Gheim2/Lidarino/src/lidarino_description/urdf/meshes/base_link_s2.stl

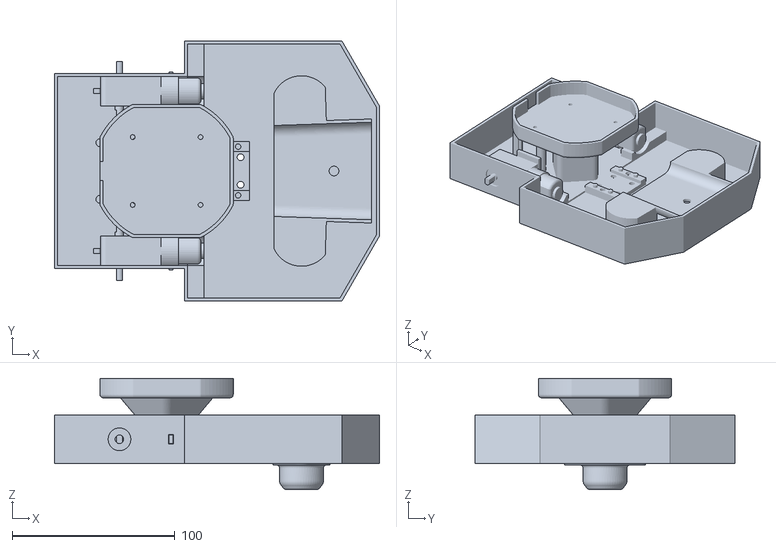
[picture p1: CAD file, 2026-06-29]
src/lidarino_description/urdf/meshes/base_link_s2.stl
200.0 x 160.0 x 68.5
