Gheim2/Lidarino/src/lidarino_description/urdf/meshes/wheel_L.stl

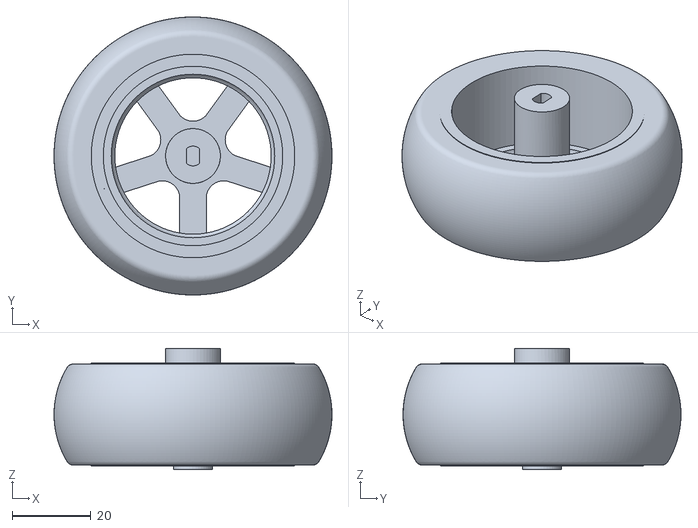
[picture p2: CAD file, 2026-05-26]
src/lidarino_description/urdf/meshes/wheel_L.stl
70.5 x 70.5 x 30.8
