Gheim2/Lidarino/(list of files, cad)

Other CAD files:
src/lidarino_description/urdf/meshes/bodyLid.stl
src/lidarino_description/urdf/meshes/astracamera.stl
src/lidarino_description/urdf/meshes/lidar.stl
src/lidarino_description/urdf/meshes/RPLIDARS2.stl
src/lidarino_description/urdf/meshes/base_link.stl
src/lidarino_description/urdf/meshes/wheel_R.stl
