Gheim2/Lidarino/src/lidarino_description/urdf/lidarino_core_s2.xacro

<?xml version='1.0' encoding='utf-8'?>
<robot xmlns:xacro="http://www.ros.org/wiki/xacro" name="Lidarino">
    
    <link name="base_link">
        <inertial>
            <origin xyz="-0.0062724127968771535 1.3799035175597654e-08 0.013070827636125267" rpy="0.0 0.0 0.0" />
            <mass value="0.4239314641509377" />
            <inertia ixx="0.0010482842137546186" iyy="0.0024338106744802982" izz="0.003184067568059869" ixy="-9.417101996162051e-05" iyz="-2.234993490616969e-06" ixz="0.0001129151524043299" />
        </inertial>
        <visual name="base_link_visual">
            <origin xyz="0.0 0.0 0.0" rpy="0.0 0.0 0.0" />
            <geometry>
                <mesh filename="${mesh_url}base_link_s2.stl" scale="0.001 0.001 0.001" />
            </geometry>
            <material name="steel_blue" />
        </visual>
        <collision name="base_link_collision">
            <origin xyz="0.0 0.0 0.021" rpy="0.0 0.0 0.0" />
            <geometry>
                <box size="0.25 0.16 0.042" /> 
            </geometry>
        </collision>
    </link>

    <link name="body_lid">
        <inertial>
            <origin xyz="-0.012951394456098867 -3.147938388524642e-07 0.06881041966340294" rpy="0.0 0.0 0.0" />
            <mass value="0.05261379951215123" />
            <inertia ixx="0.0001489352862801382" iyy="0.000229958819591738" izz="0.00037746798651689653" ixy="3.80132469862603e-10" iyz="3.2124298873716476e-11" ixz="-6.825968075725163e-07" />
        </inertial>
        <visual name="body_lid_visual">
            <origin xyz="0.0 0.0 -0.07" rpy="0.0 0.0 0.0" />
            <geometry>
                <mesh filename="${mesh_url}bodyLid.stl" scale="0.001 0.001 0.001" />
            </geometry>
            <material name="steel_blue" />
        </visual>
        <collision name="body_lid_collision">
            <origin xyz="-0.024 0.0 -0.005" rpy="0.0 0.0 0.0" />
            <geometry>
                <box size="0.206 0.164 0.014" /> 
            </geometry>
        </collision>
    </link>

    <link name="caster">
        <inertial>
            <origin xyz="0.0 0.0 0.0" rpy="0.0 0.0 0.0" />
            <mass value="0.01" />
            <inertia ixx="1e-6" iyy="1e-6" izz="1e-6" ixy="0" iyz="0" ixz="0" />
        </inertial>
        <visual name="caster_visual">
            <origin xyz="0.0 0.0 0.0" rpy="0.0 0.0 0.0" />
            <geometry>
                <sphere radius="0.008" />
            </geometry>
            <material name="silver" />
        </visual>
        <collision name="caster_collision">
            <origin xyz="0.0 0.0 0.0" rpy="0.0 0.0 0.0" />
            <geometry>
                <sphere radius="0.008" />
            </geometry>
        </collision>
    </link>
    
    <link name="wheel_R">
        <inertial>
            <origin xyz="3.8589283501977436e-08 3.3503422258718277e-13 -0.017044397508191807" rpy="0.0 -0.0 0.0" />
            <mass value="0.0493089812577897" />
            <inertia ixx="2.1725366580018456e-05" iyy="2.172573834724608e-05" izz="3.791921679166611e-05" ixy="5.925842498991085e-17" iyz="1.1233689759665433e-16" ixz="1.2860682814920879e-11" />
        </inertial>
        <visual name="wheel_R_visual">
            <origin xyz="1.1368683772161603e-15 1.3322676295501878e-17 0.0" rpy="-4.72621546065603e-16 -1.1102230246251568e-16 -2.7755575615628926e-17" />
            <geometry>
                <mesh filename="${mesh_url}wheel_R.stl" scale="0.001 0.001 0.001" />
            </geometry>
            <material name="black" />
        </visual>
        <collision name="wheel_R_collision">
            <origin xyz="0 0 -0.017" rpy="0 0 0" />
            <geometry>
                <sphere radius="0.035" />
            </geometry>
        </collision>
    </link>

    <link name="wheel_L">
        <inertial>
            <origin xyz="3.8589283501977436e-08 3.3503422258718277e-13 -0.017044397508191828" rpy="0.0 -0.0 0.0" />
            <mass value="0.0493089812577897" />
            <inertia ixx="2.17253665800184e-05" iyy="2.1725738347246244e-05" izz="3.7919216791666135e-05" ixy="5.927197751706692e-17" iyz="1.1234367386023236e-16" ixz="1.2860682842025933e-11" />
        </inertial>
        <visual name="wheel_L_visual">
            <origin xyz="1.1368683772161603e-15 1.1102230246251566e-17 0.0" rpy="-1.4649353258190343e-16 -1.2470396389907355e-32 -5.551115123125783e-17" />
            <geometry>
                <mesh filename="${mesh_url}wheel_L.stl" scale="0.001 0.001 0.001" />
            </geometry>
            <material name="black" />
        </visual>
        <collision name="wheel_L_collision">
            <origin xyz="0 0 -0.017" rpy="0 0 0" />
            <geometry>
                <sphere radius="0.035" />
            </geometry>
        </collision>
    </link>

    <joint name="L_wheel_Revolute" type="continuous">
        <origin xyz="-0.085 0.06 0.015" rpy="1.5707963267948966 -0.0 0.0" />
        <parent link="base_link" />
        <child link="wheel_L" />
        <axis xyz="0.0 0.0 -1.0" />
        <limit effort="10.0" velocity="20.0" />
    </joint>

    <joint name="R_wheel_Revolute" type="continuous">
        <origin xyz="-0.085 -0.06 0.015" rpy="-1.5707963267948966 -0.0 0.0" />
        <parent link="base_link" />
        <child link="wheel_R" />
        <axis xyz="0.0 0.0 1.0" />
        <limit effort="10.0" velocity="20.0" />
    </joint>

    <joint name="caster_fixed" type="fixed">
        <origin xyz="0.077 0.0 -0.013" rpy="0.0 0.0 0.0" />
        <parent link="base_link" />
        <child link="caster" />
    </joint>

    <joint name="body_lid_fixed" type="fixed">
        <origin xyz="0.0 0.0 0.07" rpy="0.0 0.0 0.0" />
        <parent link="base_link" />
        <child link="body_lid" />
    </joint>
</robot>
