Gheim2/Lidarino/src/lidarino_description/config/ekf.yaml

### ekf.yaml — robot_localization (EKF locale)
#
# Fonde solo velocità (le posizioni di due sorgenti si conterebbero due volte):
#   - /diff_drive_controller/odom  (encoder: vx, vy = 0, vyaw)
#   - /imu_broadcaster/imu          (giroscopio: vyaw)
#                                    Stesso topic in simulazione (bridge rimappato) e sul robot reale (imu_broadcaster)
#
# Produce:
#   - /odometry/filtered            (nav_msgs/Odometry, smooth)
#   - TF odom -> base_link
#
# NOTA: questo EKF NON tocca map->odom. Quella resta gestita da slam_toolbox.
#       world_frame è quindi "odom_frame", non "map_frame".

ekf_filter_node:
  ros__parameters:
    use_sim_time: false           # sim.launch.py lo sovrascrive a true

    frequency: 50.0               # come odometria (50 Hz) e dati IMU (50 Hz)
    sensor_timeout: 0.1
    two_d_mode: true              # il robot è un diff-drive su pavimento piano
    transform_time_offset: 0.0
    transform_timeout: 0.0
    print_diagnostics: true
    debug: false

    # Frame di riferimento
    map_frame: map
    odom_frame: odom
    base_link_frame: base_link
    world_frame: odom        # ← EKF locale: pubblica odom->base_link, NON map->odom

    # ─────────────────────────────────────────────
    # Sorgente 1: odometria da encoder (diff_drive_controller)
    # vy è sempre 0 per un diff-drive (non può muoversi di lato): fonderlo
    # impone il vincolo anolonomo, altrimenti la stima di vy deriva liberamente.
    # ─────────────────────────────────────────────
    odom0: /diff_drive_controller/odom
    odom0_config: [false,  false,  false,   # x, y, z
                    false, false, false,    # roll, pitch, yaw
                    true,  true,  false,    # vx, vy, vz
                    false, false, true,    # vroll, vpitch, vyaw
                    false, false, false]   # ax, ay, az
    odom0_queue_size: 10
    odom0_nodelay: true
    odom0_differential: false
    odom0_relative: false

    # ─────────────────────────────────────────────
    # Sorgente 2: IMU
    # Usiamo SOLO la velocità angolare di imbardata (vyaw) dal giroscopio:
    # precisa (rumore ~0.0005 rad/s) e indipendente dallo slittamento delle ruote.
    # L'orientamento non è disponibile (l'IMU non lo calcola, covarianza -1).
    # ax NON viene fuso: il robot oscilla in beccheggio quando accelera e ogni
    # grado di inclinazione aggiunge ~0.17 m/s^2 di gravità su ax; la velocità
    # viene già misurata direttamente dagli encoder. Da rivalutare con la SLAM.
    # ─────────────────────────────────────────────
    imu0: /imu_broadcaster/imu
    imu0_config: [false, false, false,   # x, y, z
                  false, false, false,    # roll, pitch, yaw
                  false, false, false,   # vx, vy, vz
                  false, false, true,    # vroll, vpitch, vyaw
                  false, false, false]   # ax, ay, az
    imu0_queue_size: 10
    imu0_nodelay: true
    imu0_differential: false
    imu0_relative: false
    # Serve solo se si fonde l'accelerazione, e richiede un orientamento che l'IMU non fornisce
    imu0_remove_gravitational_acceleration: false

    # ─────────────────────────────────────────────
    # Modello di processo: quanto il filtro "si fida" della predizione
    # tra un update e l'altro. Valori più bassi = più fiducia nel modello,
    # più alti = più fiducia nelle misure.
    # ─────────────────────────────────────────────
    process_noise_covariance: [0.05, 0.0,    0.0,    0.0,    0.0,    0.0,    0.0,     0.0,     0.0,    0.0,    0.0,    0.0,    0.0,    0.0,    0.0,
                                0.0,    0.05, 0.0,    0.0,    0.0,    0.0,    0.0,     0.0,     0.0,    0.0,    0.0,    0.0,    0.0,    0.0,    0.0,
                                0.0,    0.0,    0.06, 0.0,    0.0,    0.0,    0.0,     0.0,     0.0,    0.0,    0.0,    0.0,    0.0,    0.0,    0.0,
                                0.0,    0.0,    0.0,    0.03, 0.0,    0.0,    0.0,     0.0,     0.0,    0.0,    0.0,    0.0,    0.0,    0.0,    0.0,
                                0.0,    0.0,    0.0,    0.0,    0.03, 0.0,    0.0,     0.0,     0.0,    0.0,    0.0,    0.0,    0.0,    0.0,    0.0,
                                0.0,    0.0,    0.0,    0.0,    0.0,    0.06, 0.0,     0.0,     0.0,    0.0,    0.0,    0.0,    0.0,    0.0,    0.0,
                                0.0,    0.0,    0.0,    0.0,    0.0,    0.0,    0.025, 0.0,     0.0,    0.0,    0.0,    0.0,    0.0,    0.0,    0.0,
                                0.0,    0.0,    0.0,    0.0,    0.0,    0.0,    0.0,     0.025, 0.0,    0.0,    0.0,    0.0,    0.0,    0.0,    0.0,
                                0.0,    0.0,    0.0,    0.0,    0.0,    0.0,    0.0,     0.0,     0.04, 0.0,    0.0,    0.0,    0.0,    0.0,    0.0,
                                0.0,    0.0,    0.0,    0.0,    0.0,    0.0,    0.0,     0.0,     0.0,    0.01, 0.0,    0.0,    0.0,    0.0,    0.0,
                                0.0,    0.0,    0.0,    0.0,    0.0,    0.0,    0.0,     0.0,     0.0,    0.0,    0.01, 0.0,    0.0,    0.0,    0.0,
                                0.0,    0.0,    0.0,    0.0,    0.0,    0.0,    0.0,     0.0,     0.0,    0.0,    0.0,    0.02, 0.0,    0.0,    0.0,
                                0.0,    0.0,    0.0,    0.0,    0.0,    0.0,    0.0,     0.0,     0.0,    0.0,    0.0,    0.0,    0.01, 0.0,    0.0,
                                0.0,    0.0,    0.0,    0.0,    0.0,    0.0,    0.0,     0.0,     0.0,    0.0,    0.0,    0.0,    0.0,    0.01, 0.0,
                                0.0,    0.0,    0.0,    0.0,    0.0,    0.0,    0.0,     0.0,     0.0,    0.0,    0.0,    0.0,    0.0,    0.0,    0.015]

    # Covarianza iniziale dello stato (incertezza a t=0)
    initial_estimate_covariance: [1e-9, 0.0,    0.0,    0.0,    0.0,    0.0,    0.0,    0.0,    0.0,    0.0,    0.0,    0.0,    0.0,    0.0,    0.0,
                                   0.0,    1e-9, 0.0,    0.0,    0.0,    0.0,    0.0,    0.0,    0.0,    0.0,    0.0,    0.0,    0.0,    0.0,    0.0,
                                   0.0,    0.0,    1e-9, 0.0,    0.0,    0.0,    0.0,    0.0,    0.0,    0.0,    0.0,    0.0,    0.0,    0.0,    0.0,
                                   0.0,    0.0,    0.0,    1e-9, 0.0,    0.0,    0.0,    0.0,    0.0,    0.0,    0.0,    0.0,    0.0,    0.0,    0.0,
                                   0.0,    0.0,    0.0,    0.0,    1e-9, 0.0,    0.0,    0.0,    0.0,    0.0,    0.0,    0.0,    0.0,    0.0,    0.0,
                                   0.0,    0.0,    0.0,    0.0,    0.0,    1e-9, 0.0,    0.0,    0.0,    0.0,    0.0,    0.0,    0.0,    0.0,    0.0,
                                   0.0,    0.0,    0.0,    0.0,    0.0,    0.0,    1e-9, 0.0,    0.0,    0.0,    0.0,    0.0,    0.0,    0.0,    0.0,
                                   0.0,    0.0,    0.0,    0.0,    0.0,    0.0,    0.0,    1e-9, 0.0,    0.0,    0.0,    0.0,    0.0,    0.0,    0.0,
                                   0.0,    0.0,    0.0,    0.0,    0.0,    0.0,    0.0,    0.0,    1e-9, 0.0,    0.0,    0.0,    0.0,    0.0,    0.0,
                                   0.0,    0.0,    0.0,    0.0,    0.0,    0.0,    0.0,    0.0,    0.0,    1e-9, 0.0,    0.0,    0.0,    0.0,    0.0,
                                   0.0,    0.0,    0.0,    0.0,    0.0,    0.0,    0.0,    0.0,    0.0,    0.0,    1e-9, 0.0,    0.0,    0.0,    0.0,
                                   0.0,    0.0,    0.0,    0.0,    0.0,    0.0,    0.0,    0.0,    0.0,    0.0,    0.0,    1e-9, 0.0,    0.0,    0.0,
                                   0.0,    0.0,    0.0,    0.0,    0.0,    0.0,    0.0,    0.0,    0.0,    0.0,    0.0,    0.0,    1e-9, 0.0,    0.0,
                                   0.0,    0.0,    0.0,    0.0,    0.0,    0.0,    0.0,    0.0,    0.0,    0.0,    0.0,    0.0,    0.0,    1e-9, 0.0,
                                   0.0,    0.0,    0.0,    0.0,    0.0,    0.0,    0.0,    0.0,    0.0,    0.0,    0.0,    0.0,    0.0,    0.0,    1e-9]
