Gheim2/Lidarino/(commit log)

2026-05-26 Improve Gazebo lidar simulation and wheel dynamics
    - make the lidar merger follow the rotating joint and publish a 360 degree scan
    - add cylindrical wheel collisions with friction tuning for better Gazebo contact
    - introduce a custom Gazebo world with sensor plugins and boundary walls
    - update launch, controller, and packaging files for the new simulation setup
    - refresh the ROS helper script to rebuild and source the workspace before launching
    [Lidarino.urdf, Lidarino.urdf.xacro, controllers.yaml]
2026-05-26 Add differential drive teleop and improve simulation stability
    - add a diff drive controller so the robot can be driven from the keyboard and launched from ros_manager.py
    - switch wheel collision geometry to spheres to reduce simulation drift
    - retune mass and inertia values to better match the lighter 3D printed robot
    - update Gazebo launch and controller configuration for the new drive setup
    [Lidarino.urdf, Lidarino.urdf.xacro, controllers.yaml]
2026-05-26 Added Slam - Added slam_toolbox to recognise the environment and create a map - Added useful commands in ros_manager.py - Modified tof_merger to forget points seen in the past
    [controllers.yaml]
2026-06-08 Split URDF into multiple xacro files - Added Camera to the robot for future use in navigation and object detection - lidarino.urdf.xacro: main file, includes all the others - lidarino_core.xacro: cor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
    [Lidarino.urdf, Lidarino.urdf.xacro, astra_camera.xacro, lidarino.urdf.xacro, lidarino_core.xacro, lidarino_gazebo.xacro, lidarino_ros2_control.xacro, materials.xacro]
2026-06-08 Bug fix: Add fixed joint for caster - Added a fixed joint for the caster to ensure it is properly attached to the base link. - Updated the collision properties for the caster to prevent it from affec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
    [astra_camera.xacro, lidarino_core.xacro, lidarino_gazebo.xacro]
2026-06-29 BIG CHANGES IN THIS COMMIT: - Added support for Lidarino s2 (RPLIDAR S2) in the ROS 2 workspace (meshes, urdf, launch files). - Added possibility of choosing the Lidarino version in the ROS 2 manager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
    [RPLIDARS2.stl, astra_camera.xacro, astracamera.stl, base_link_s2.stl, controllers_s2.yaml, controllers_v1.yaml, lidarino_core_s2.xacro, lidarino_core_v1.xacro]
2026-06-30 Autonomous exploration, Imu, EKF, optimization - Created file launch_sim.sh to launch the simulation with Gazebo and avoid ctrl-c problems - Added imu.xacro file to the lidarino_description package -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
    [astra_camera.xacro, controllers_s2.yaml, imu.xacro, lidarino_s2.urdf.xacro, rplidars2.xacro]
2026-06-30 Chore: third-party ROS 2 packages added via .repos - Added m-explore-ros2 and sllidar_ros2 as third-party packages in the src directory. - Created lidarino_hardware package with necessary files and c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
    [lidarino_ros2_control.xacro]
2026-06-30 Add physical robot support
    - Add lidarino_bringup package with robot.launch.py for hardware execution
    - Add controllers_real.yaml for non-simulated control (use_sim_time: false)
    - Fix: Add 'use_sim' xacro argument in lidarino_s2.urdf.xacro to toggle between gazebo and real hardware
    - Update gazebo.launch.py to pass correct xacro arguments
    - Configure CMakeLists for lidarino_bringup deployment
    [controllers_real.yaml, lidarino_s2.urdf.xacro]
2026-07-16 Bug fix - Added setup_configuration.sh file for avoiding problems with compilation of unnecessaries folders - Updated README.md - Solved lidarino.repos bug in which it saved the vcs downloads in src/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
2026-09-05 Moved launch files to lidarino_bringup - Moved navigation.launch.py, sim.launch.py (old gazebo.launch.py), and slam.launch.py from lidarino_description to lidarino_bringup. - Updated sim.launch.py to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
2026-09-06 Updated mesh files and URDF - Updated all the mesh file with the new mesh files from the CAD model. - Updated the URDF files to reflect the new mesh files, their positions and the collision geometry.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
    [RPLIDARS2.stl, astracamera.stl, base_link.stl, base_link_s2.stl, bodyLid.stl, imu.xacro, lidar.stl, lidarino_core_s2.xacro]
2026-09-06 Better split between main and Isaac Sim branch - Added sim argument to xacro files to differentiate between Gazebo and Isaac Sim - Removed old meshes
    [astra_camera.xacro, base_link_s2.stl, imu.xacro, rplidars2.xacro, tof_sensor.xacro, wheel_L.stl, wheel_R.stl]
2026-09-27 Updated functionality: - Added IMU sensor support to the Lidarino hardware interface, including state interfaces for accelerometer and gyroscope data. - Updated the controllers configuration to inclu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
    [controllers_real.yaml, lidarino_ros2_control.xacro]
2026-09-28 Docker Compatibility and bug fixes
    [lidarino_ros2_control.xacro, lidarino_s2.urdf.xacro]
2026-09-29 Bug fixes
    [lidarino_ros2_control.xacro]
2026-10-01 Fixed bugs and added new features - Fixed bug in lidarino_hardware.cpp that caused the ESP32 to crash when connecting - Added battery publisher node to publish battery status to ROS2 - Updated CMakeL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
    [lidarino_hardware.cpp, lidarino_hardware.hpp]
2026-10-01 Add battery speaker script and update Dockerfile - Now the system can announce battery voltage using the speaker - Added battery_speaker.py script - Updated Dockerfile to include espeak-ng and alsa-u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
2026-10-12 Enhance battery speaker functionality and update dependencies in Dockerfile
    - Added new ROS 2 packages to Dockerfile for improved functionality.
    - Updated battery speaker script to calculate average voltage over a sampling period.
    - Removed unused battery publisher implementation.
    - Updated lidarino.repos to include new camera package.
    - Modified .gitignore to exclude additional directories.
    - Adjusted docker-compose.yml for environment variables and device configurations.
2026-10-12 Update wheel radius in controller configurations and modify IMU state interfaces for consistency
2026-10-28 Bug fix - Added missing orientation parameters for the IMU - Updated checksum
2026-10-28 Robust serial link, wheel mapping by name, IMU topic and EKF setup
    lidarino_hardware:
    - Serial port fully raw (cfmakeraw): ICRNL turned every 0x0D terminator
    into 0x0A, so telemetry was dropped
    - Wheels mapped by joint name (left_wheel_joint / right_wheel_joint params
    in the xacro) instead of declaration order, which swapped left and right
    - Telemetry checksum accepts only the full-frame XOR, like the firmware;
    mismatch warning now reachable
    - write() never returns ERROR: EAGAIN or a partial write skips the cycle,
    a real error closes the port. One EAGAIN used to deactivate the hardware
    and all controllers
    - Automatic reconnect when the ESP32 resets (port reopened every second),
    j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
2026-10-28 IMU and wheel odometry covariances, EKF fuses only velocities
    controllers_real.yaml:
    - imu_broadcaster: covariances measured with imu_covariance.py (robot still,
    1000 samples at 50 Hz). Orientation not available, gyro as
    measured, accel measured x100 because driving vibration raises the noise
    - diff_drive_controller: twist/pose covariance diagonals (they were all 0).
    Starting values, to be refined with hand-push tests (2 m straight line,
    3 turns in place)
    ekf.yaml:
    - IMU: fuse only vyaw from the gyro. ax removed: robot pitch leaks gravity
    into ax (~0.17 m/s^2 per degree) and the encoders already measure vx
    - imu0_remove_gravitational_acceleration off (needs an orientation the IMU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
2026-10-29 Odometry TF, lidar in robot launch and serial link diagnostics
    - Fix: nothing published odom -> base_link on the real robot
    (enable_odom_tf: false and EKF off by default). The diff drive
    controller now publishes it; with use_ekf:=true the spawner loads
    diff_drive_no_odom_tf.yaml so only the EKF publishes it
    - robot.launch.py starts the RPLIDAR S2 (use_lidar:=true by default)
    with config/sllidar_s2.yaml, frame_id rplidars2_laser_link from the
    URDF. sllidar_s2_launch.py used "laser", not in the TF tree, so RViz
    could not show the scan
    - lidarino_hardware: every 2 s reports how many commands were skipped
    (output buffer full) and warns when no valid telemetry arrived for
    more tha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
